chronopoulos/quadrant-board/README.md

# Quadrant
an open-hardware interface for musical expression

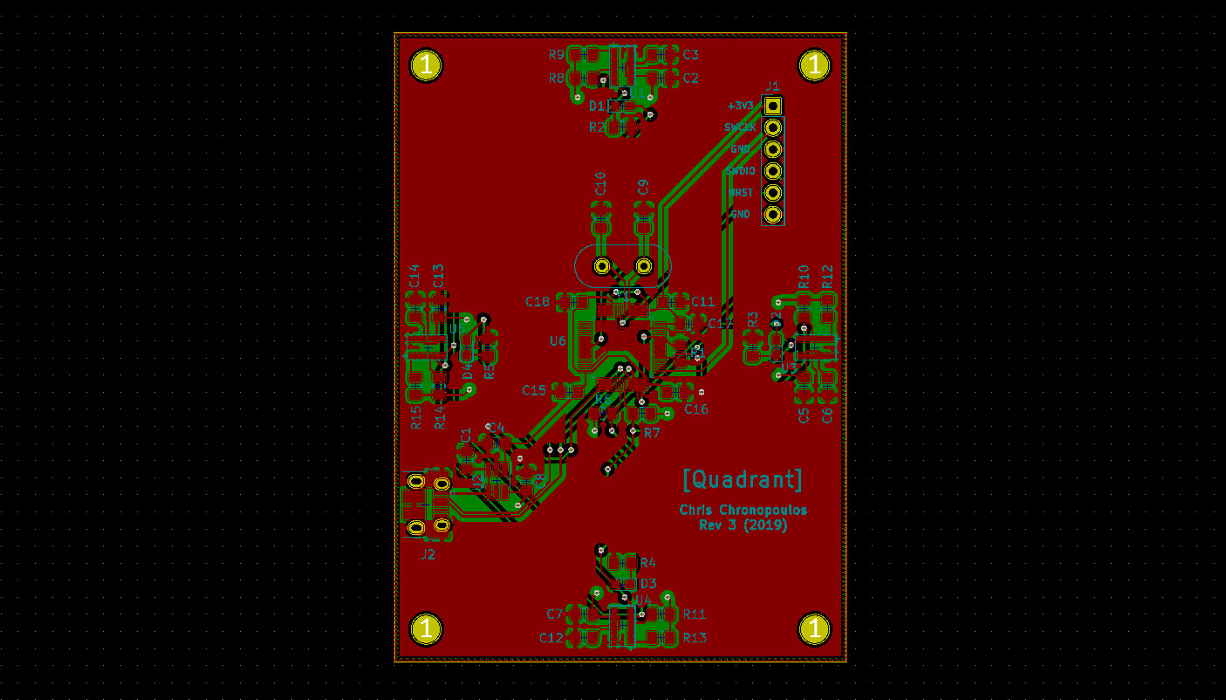
[picture p1: img/rev3.jpg]
rev3
