chronopoulos/quadrant-board/schematic.pdf

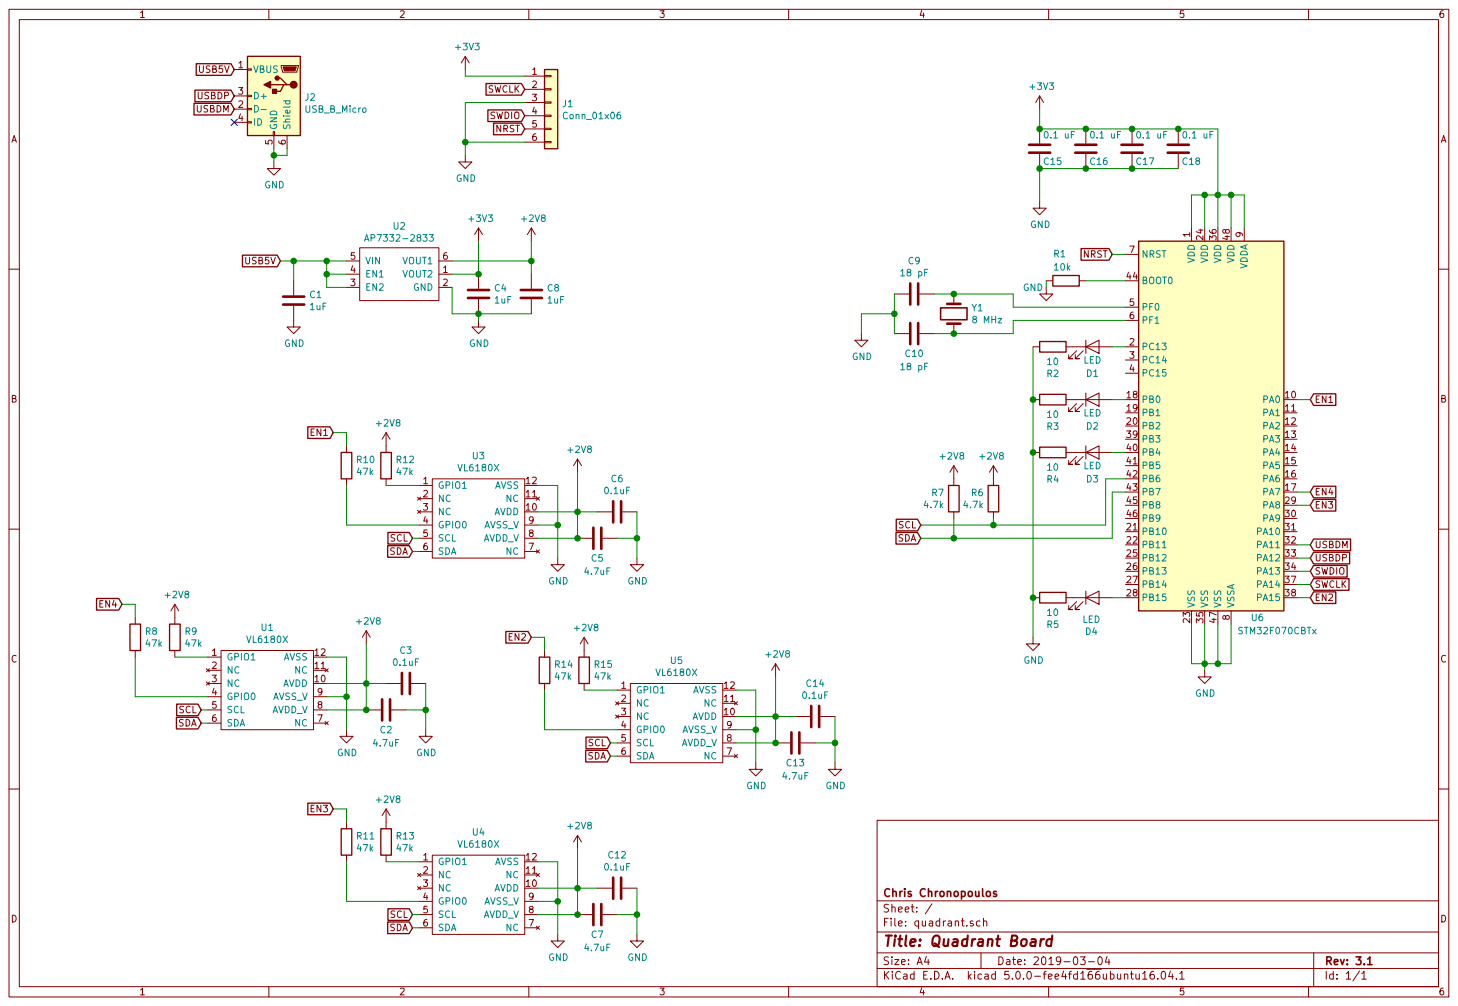
[picture p2: page 1]

1 VDD 24 VDD 36 VDD 48 VDDA

9 VSS 23 VSS 35 VSS 47 VSSA

File: quadrant.sch Sheet: / Chris Chronopoulos

Id: 1/1 Title: Quadrant Board
