chronopoulos/quadrant-board/(commit log)

2018-10-22 add bom.csv
    [bom.csv]
2018-10-22 update schematic for rev 2
    [quadrant.sch]
2018-10-26 bom.csv: switch AZ1117 from SOT-223 to SOT-89
    [bom.csv]
2018-10-26 associate footprints with schematic symbols
    [quadrant.sch]
2018-10-29 quadrant.net: update netlist with new footprints
2018-10-29 change NPN schematic symbols from BCE to BEC
    [quadrant.sch]
2018-10-29 .gitignore: add *.kicad-pcb-bak
2018-10-30 quadrant.kicad_pcb: new layout for rev 2
    [quadrant.kicad_pcb]
2018-10-30 generate gerbers for rev 2
    [quadrant-B.Cu.gbr, quadrant-B.Mask.gbr, quadrant-B.SilkS.gbr, quadrant-Edge.Cuts.gbr, quadrant-F.Cu.gbr, quadrant-F.Mask.gbr, quadrant-F.SilkS.gbr, quadrant.drl]
2018-11-05 plot updated schematic.pdf for rev 2
    [quadrant.sch]
2018-11-06 bom.csv: delete superfluous parts that were added by mistake
    [bom.csv]
2018-11-06 bom.csv: update BOM for rev 2
    [bom.csv]
2018-11-06 bom.csv: swap 6.3V capacitor out for 16V (22uF)
    [bom.csv]
2018-11-16 schematic: changed load capacitors on crystal oscillator to 18 pF
    [quadrant.sch]
2019-01-09 quadrant.lib: add schematic symbol for VL6180X
2019-01-09 quadrant.sch: first pass at a rev 3 schematic
    [quadrant.sch]
2019-01-11 add footprint: VL6180X.kicad_mod
2019-01-11 add schematic symbol: MIC5399-SMYMX
2019-01-11 quadrant.sch: add LEDs, and update symbol for LDO
    [quadrant.sch]
2019-01-11 quadrant.sch: annotate symbols
    [quadrant.sch]
2019-01-11 quadrant.sch: assign footprints
    [quadrant.sch]
2019-01-11 quadrant.sch: add 47k pull-ups for VL6180X GPIOs
    [quadrant.sch]
2019-01-11 quadrant.sch: add 4.7uF bypass caps to AVDD_VCSEL on VL6180x
    [quadrant.sch]
2019-01-14 replace MIC5399 with AP7332
    [quadrant.sch]
2019-01-15 add a decoupling cap for each VDD pin
    [quadrant.sch]
2019-01-15 finalize LEDs: 0603 with 6.8 ohm resistors
    [quadrant.sch]
2019-01-15 finalize placement for rev 3
    [quadrant.kicad_pcb]
2019-01-15 change VCC to 3V3 on SWD header
    [quadrant.sch]
2019-01-16 connect pin 6 of SWD header to GND
    [quadrant.sch]
2019-01-16 finalize layout for rev 3
    [quadrant.kicad_pcb]
2019-01-16 generate Gerbers for rev 3
    [quadrant-B.Cu.gbr, quadrant-B.Mask.gbr, quadrant-B.SilkS.gbr, quadrant-Edge.Cuts.gbr, quadrant-F.Cu.gbr, quadrant-F.Mask.gbr, quadrant-F.SilkS.gbr, quadrant.drl]
2019-01-17 update BOM for rev 3
    [bom.csv]
2019-01-22 fix disconnected 2V8 net
    [quadrant-B.Cu.gbr, quadrant-B.Mask.gbr, quadrant-B.SilkS.gbr, quadrant-Edge.Cuts.gbr, quadrant-F.Cu.gbr, quadrant-F.Mask.gbr, quadrant-F.SilkS.gbr, quadrant.drl]
2019-01-22 update board image to rev 3
2019-01-22 schematic.pdf: update for rev 3
2019-02-10 quadrant.sch: update for rev 3.1
    reroute i2c lines to PB6/PB7
    route VL6180x:GPIO0's to the MCU
    move LED lines for convenience in routing
    [quadrant.sch]
2019-03-04 update layout for rev 3.1
    [quadrant.kicad_pcb, quadrant.sch]
2019-03-04 quadrant.kicad_pcb: add mounting holes
    [quadrant.kicad_pcb]
2019-03-04 quadrant.kicad_pcb: add rounded corners
    [quadrant.kicad_pcb]
2019-03-04 generate Gerbers for rev 3.1
    [quadrant-B.Cu.gbr, quadrant-B.Mask.gbr, quadrant-B.SilkS.gbr, quadrant-Edge.Cuts.gbr, quadrant-F.Cu.gbr, quadrant-F.Mask.gbr, quadrant-F.SilkS.gbr, quadrant-NPTH.drl]
2019-03-04 current-limiting resistors: 6.8 -> 10 ohm
    [bom.csv, quadrant.kicad_pcb, quadrant.sch]
2019-03-05 bom.csv: ditch C11 bypass cap
    [bom.csv]
2019-03-05 gerbers: add paste layer
    [quadrant-B.Cu.gbr, quadrant-B.Mask.gbr, quadrant-B.SilkS.gbr, quadrant-Edge.Cuts.gbr, quadrant-F.Cu.gbr, quadrant-F.Mask.gbr, quadrant-F.Paste.gbr, quadrant-F.SilkS.gbr]
2019-03-19 schematic.pdf: update for rev 3.1
2019-04-19 add pick-and-place file: quadrant-all.pos
    [quadrant.kicad_pcb]
